smile5/Sonde_diff/CAO/sonde_diff_v0_1.kicad_pcb

## KiCad design CAO/sonde_diff_v0_1.kicad_pcb (2024-01-08)

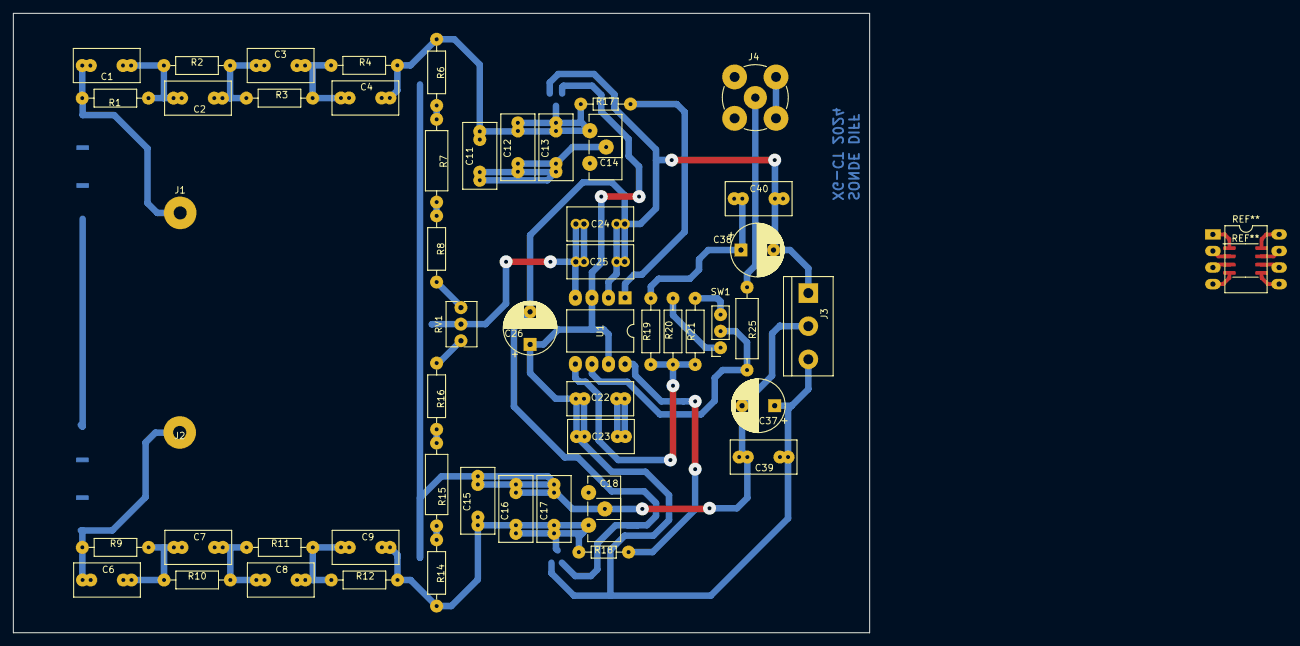
[picture p1: board sonde_diff_v0_1.kicad_pcb from above]

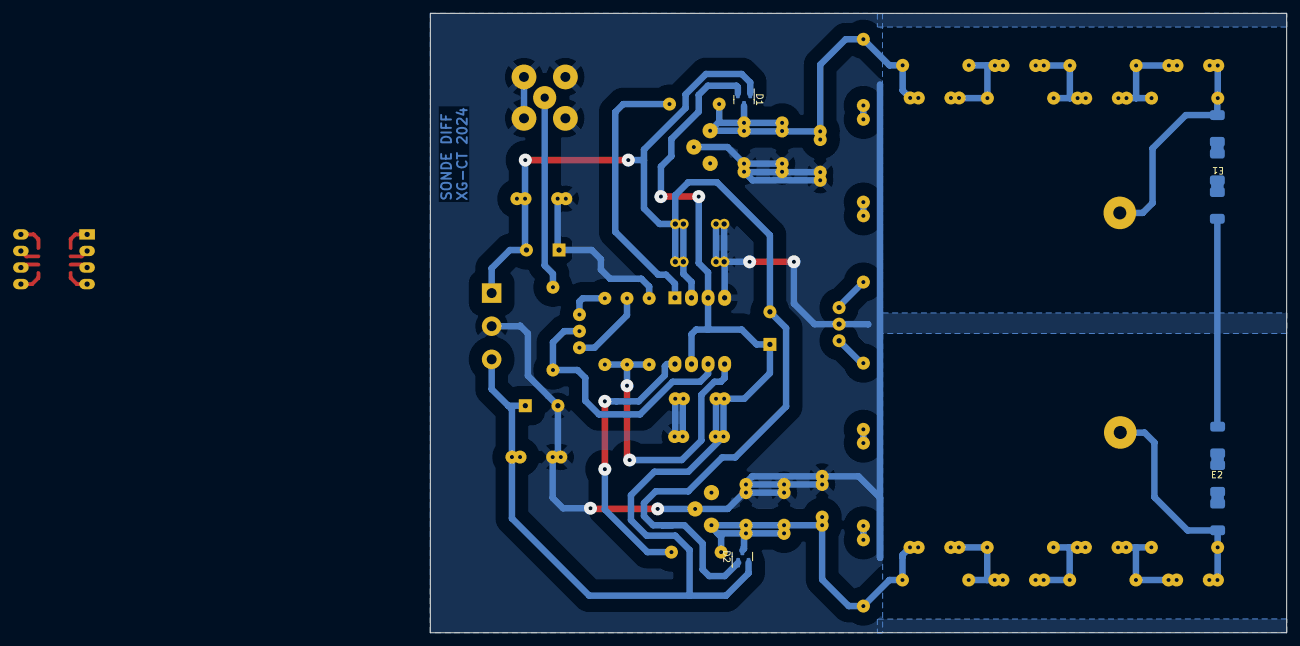
[picture p2: board sonde_diff_v0_1.kicad_pcb from below]

Board: 2 copper layers, 131.3 x 95.0 mm, 56 parts (4 on the bottom side), 26 nets.

Parts:
C1, C2, C3, C4, C6, C7, C8, C9: 10p; C_Rect_L10.0mm_W5.0mm_P5.00mm_P7.50mm
C11, C15: 470p; C_Rect_L10.0mm_W5.0mm_P5.00mm_P7.50mm
C12, C16: 47p; C_Rect_L10.0mm_W5.0mm_P5.00mm_P7.50mm
C13, C17: 22p; C_Rect_L10.0mm_W5.0mm_P5.00mm_P7.50mm
C14, C18: 8p; Potentiometer_ACP_CA9-H2,5_Horizontal
C22, C25, C39, C40: 100n; C_Rect_L10.0mm_W5.0mm_P5.00mm_P7.50mm
C23, C24: 100p; C_Rect_L10.0mm_W5.0mm_P5.00mm_P7.50mm
C26: 4.7u; CP_Radial_D8.0mm_P5.00mm
C37, C38: 10u; CP_Radial_D8.0mm_P5.00mm
D1, D2: BAV99; SOT-23
E1, E2: SparkGap; Spark_gap_1200
J1, J2: Conn_01x01; PIN_3mm
J3: Conn_01x03; TerminalBlock_bornier-3_P5.08mm
J4: Conn_Coaxial; BNC_TEConnectivity_1478204_Vertical
R1, R2, R3, R4, R9, R10, R11, R12: 1M; R_Axial_DIN0207_L6.3mm_D2.5mm_P10.16mm_Horizontal
R6, R14: 15k; R_Axial_DIN0207_L6.3mm_D2.5mm_P10.16mm_Horizontal
R7, R15: 2.2k; R_Axial_DIN0309_L9.0mm_D3.2mm_P12.70mm_Horizontal
R8, R16: 64; R_Axial_DIN0207_L6.3mm_D2.5mm_P10.16mm_Horizontal
R17, R18: 1500; R_Axial_DIN0204_L3.6mm_D1.6mm_P7.62mm_Horizontal
R19: 5000; R_Axial_DIN0207_L6.3mm_D2.5mm_P10.16mm_Horizontal
R20: 6000; R_Axial_DIN0207_L6.3mm_D2.5mm_P10.16mm_Horizontal
R21: 105000; R_Axial_DIN0207_L6.3mm_D2.5mm_P10.16mm_Horizontal
R25: 50; R_Axial_DIN0309_L9.0mm_D3.2mm_P12.70mm_Horizontal
RV1: 2K; Potentiometer_Bourns_3266Y_Vertical
SW1: SW_DPDT_x2; PinSocket_1x03_P2.54mm_Vertical
U1: DIP-8_W10.16mm

Connections:
GNDPWR: C11.2, C12.2, C13.2, C14.2, C15.2, C16.2, C17.2, C18.2, C22.2, C23.2, C24.2, C25.2, C37.2, C38.1, C39.2, C40.1, E1.1, E2.1, J3.2, J4.2 (Ext), R19.1, RV1.2, U1.4 (REF)
unnamed: C1.2, C2.1, R1.2, R2.1
unnamed: C2.2, C3.1, R2.2, R3.1
unnamed: C3.2, C4.1, R3.2, R4.1
unnamed: C6.2, C7.1, R9.2, R10.1
unnamed: C7.2, C8.1, R10.2, R11.1
unnamed: C8.2, C9.1, R11.2, R12.1
unnamed: C4.2, C11.1, C12.1, C13.1, C14.1, D1.3 (K), R4.2, R6.1, R17.1
unnamed: C9.2, C15.1, C16.1, C17.1, C18.1, D2.3 (K), R12.2, R14.1, R18.1
unnamed: C1.1, E1.2, J1.1, R1.1
unnamed: C6.1, E2.2, J2.1, R9.1
unnamed: J4.1 (In), R25.2
unnamed: R6.2, R7.1
unnamed: R7.2, R8.1
unnamed: R8.2, RV1.1
unnamed: R14.2, R15.1
unnamed: R15.2, R16.1
unnamed: R16.2, RV1.3
unnamed: R20.2, SW1.1 (A)
unnamed: R25.1, SW1.2 (B), U1.6
unnamed: R21.2, SW1.3 (C)
unnamed: R17.2, U1.1 (+)
unnamed: R18.2, U1.8 (-)
unnamed: R19.2, R20.1, R21.1, U1.5 (FB)
VCC: C22.1, C23.1, C26.1, C37.1, C39.1, D1.2 (A), D2.2 (A), J3.3, U1.3 (~PD), U1.7 (V+)
VEE: C24.1, C25.1, C26.2, C38.2, C40.2, D1.1 (K), D2.1 (K), J3.1, U1.2 (V-)
